servalproject/foss-comms-tower/WiFindUs-Tower/WFU_TripodEndJoiner_DN20-18.stl

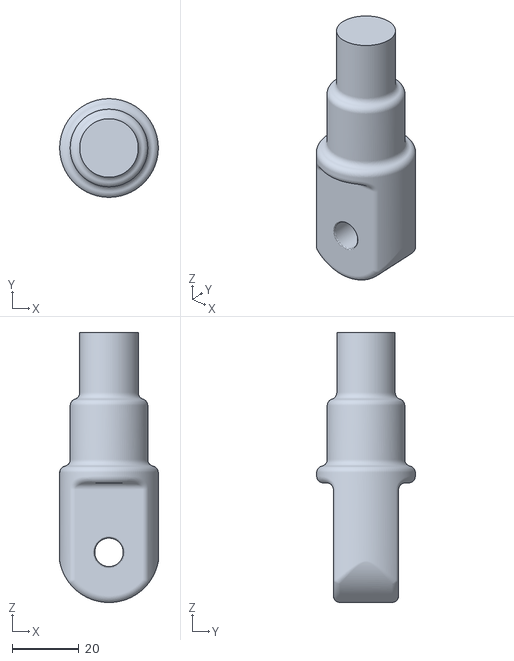
[picture p1: CAD file, 2014-07-04]
WiFindUs-Tower/WFU_TripodEndJoiner_DN20-18.stl
29.5 x 29.5 x 80.8
