servalproject/foss-comms-tower/WiFindUs-Tower/WFU_TripodLegFooting_DN25C.stl

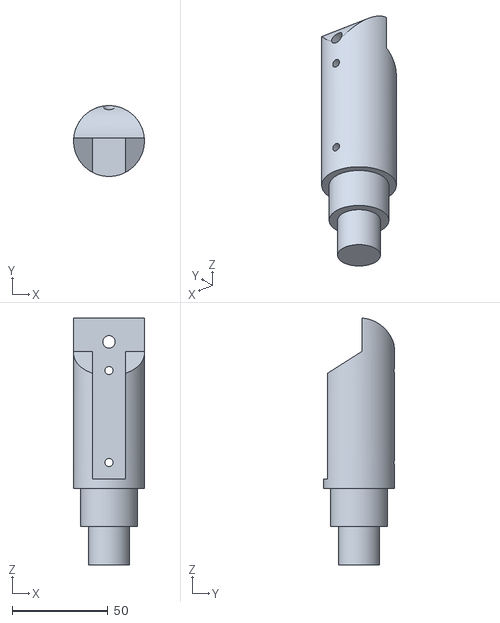
[picture p2: CAD file, 2014-07-04]
WiFindUs-Tower/WFU_TripodLegFooting_DN25C.stl
37.0 x 37.0 x 128.9
