servalproject/foss-comms-tower/WiFindUs-Tower/WFU_ElectronicsHousingInsert.stl

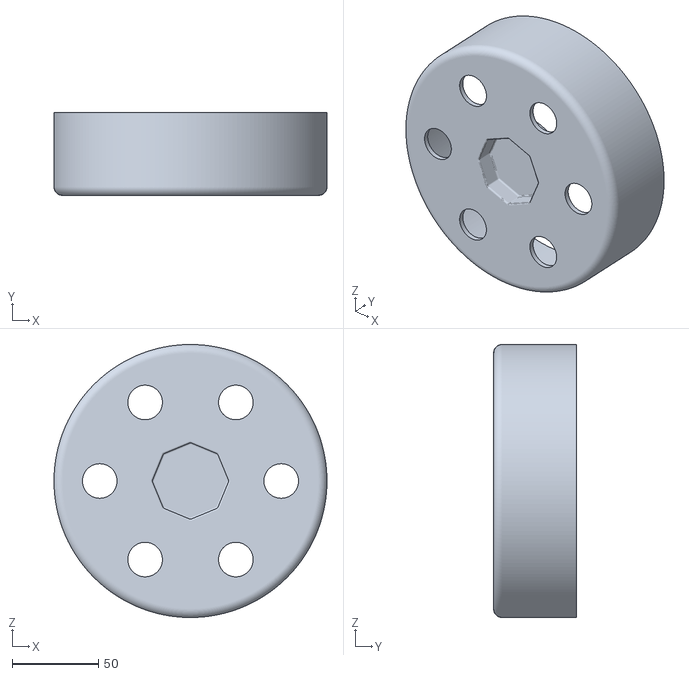
[picture p3: CAD file, 2014-07-04]
WiFindUs-Tower/WFU_ElectronicsHousingInsert.stl
158.0 x 48.0 x 158.0
