servalproject/foss-comms-tower/WiFindUs-Tower/WFU_TripodEndJoiner_DN25.stl

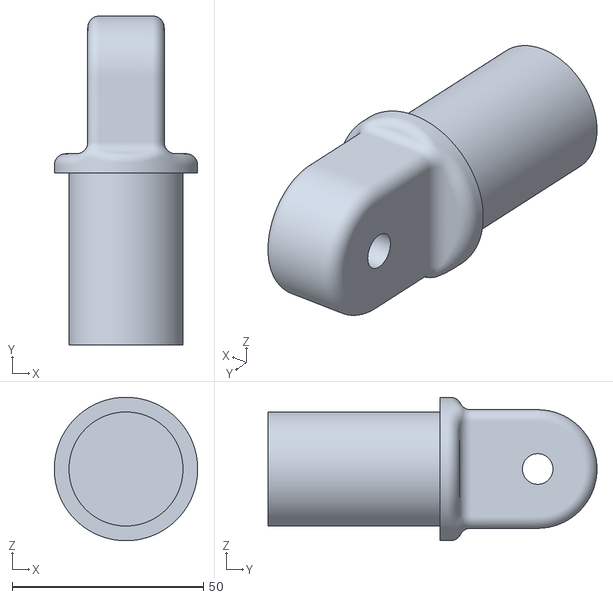
[picture p4: CAD file, 2014-07-04]
WiFindUs-Tower/WFU_TripodEndJoiner_DN25.stl
37.5 x 86.0 x 37.5
