servalproject/foss-comms-tower/WiFindUs-Tower/WFU_TripodCollar.stl

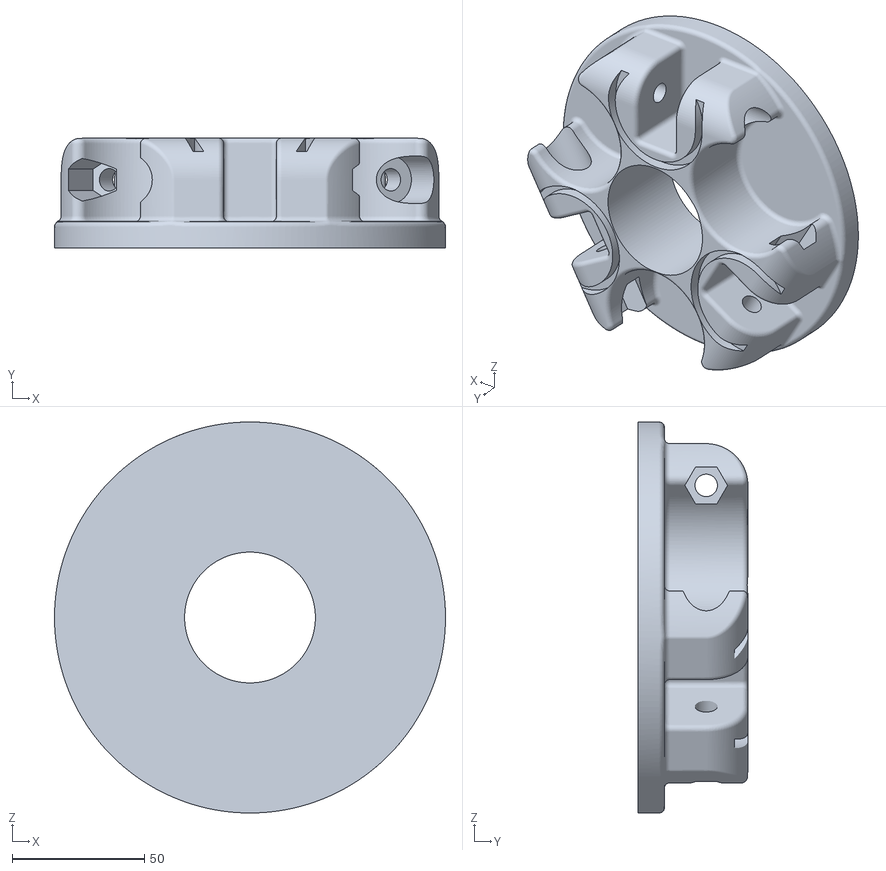
[picture p5: CAD file, 2014-07-04]
WiFindUs-Tower/WFU_TripodCollar.stl
148.0 x 41.6 x 148.0
