servalproject/foss-comms-tower/WiFindUs-Tower/WFU_TripodInlineJoiner_DN25-25C.stl

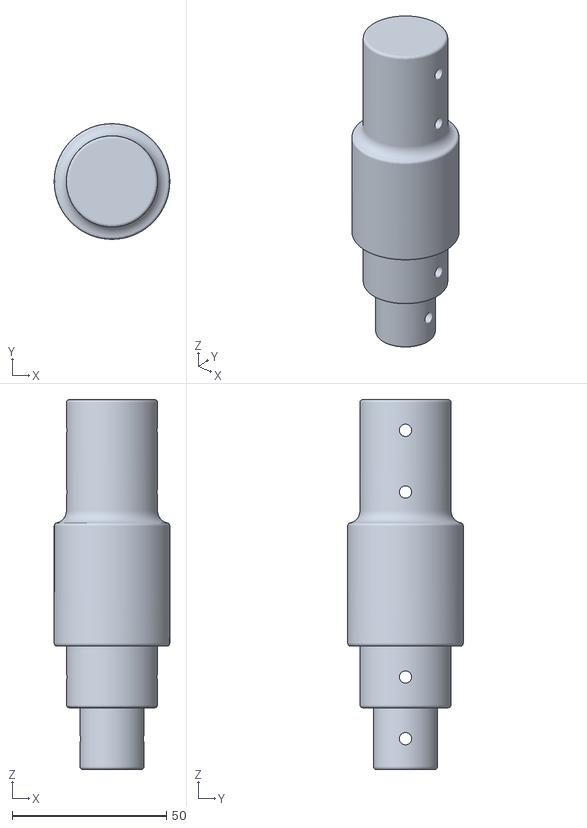
[picture p6: CAD file, 2014-07-04]
WiFindUs-Tower/WFU_TripodInlineJoiner_DN25-25C.stl
37.5 x 37.5 x 120.0
