servalproject/foss-comms-tower/WiFindUs-Tower/WFU-Tower-Assembly.pdf

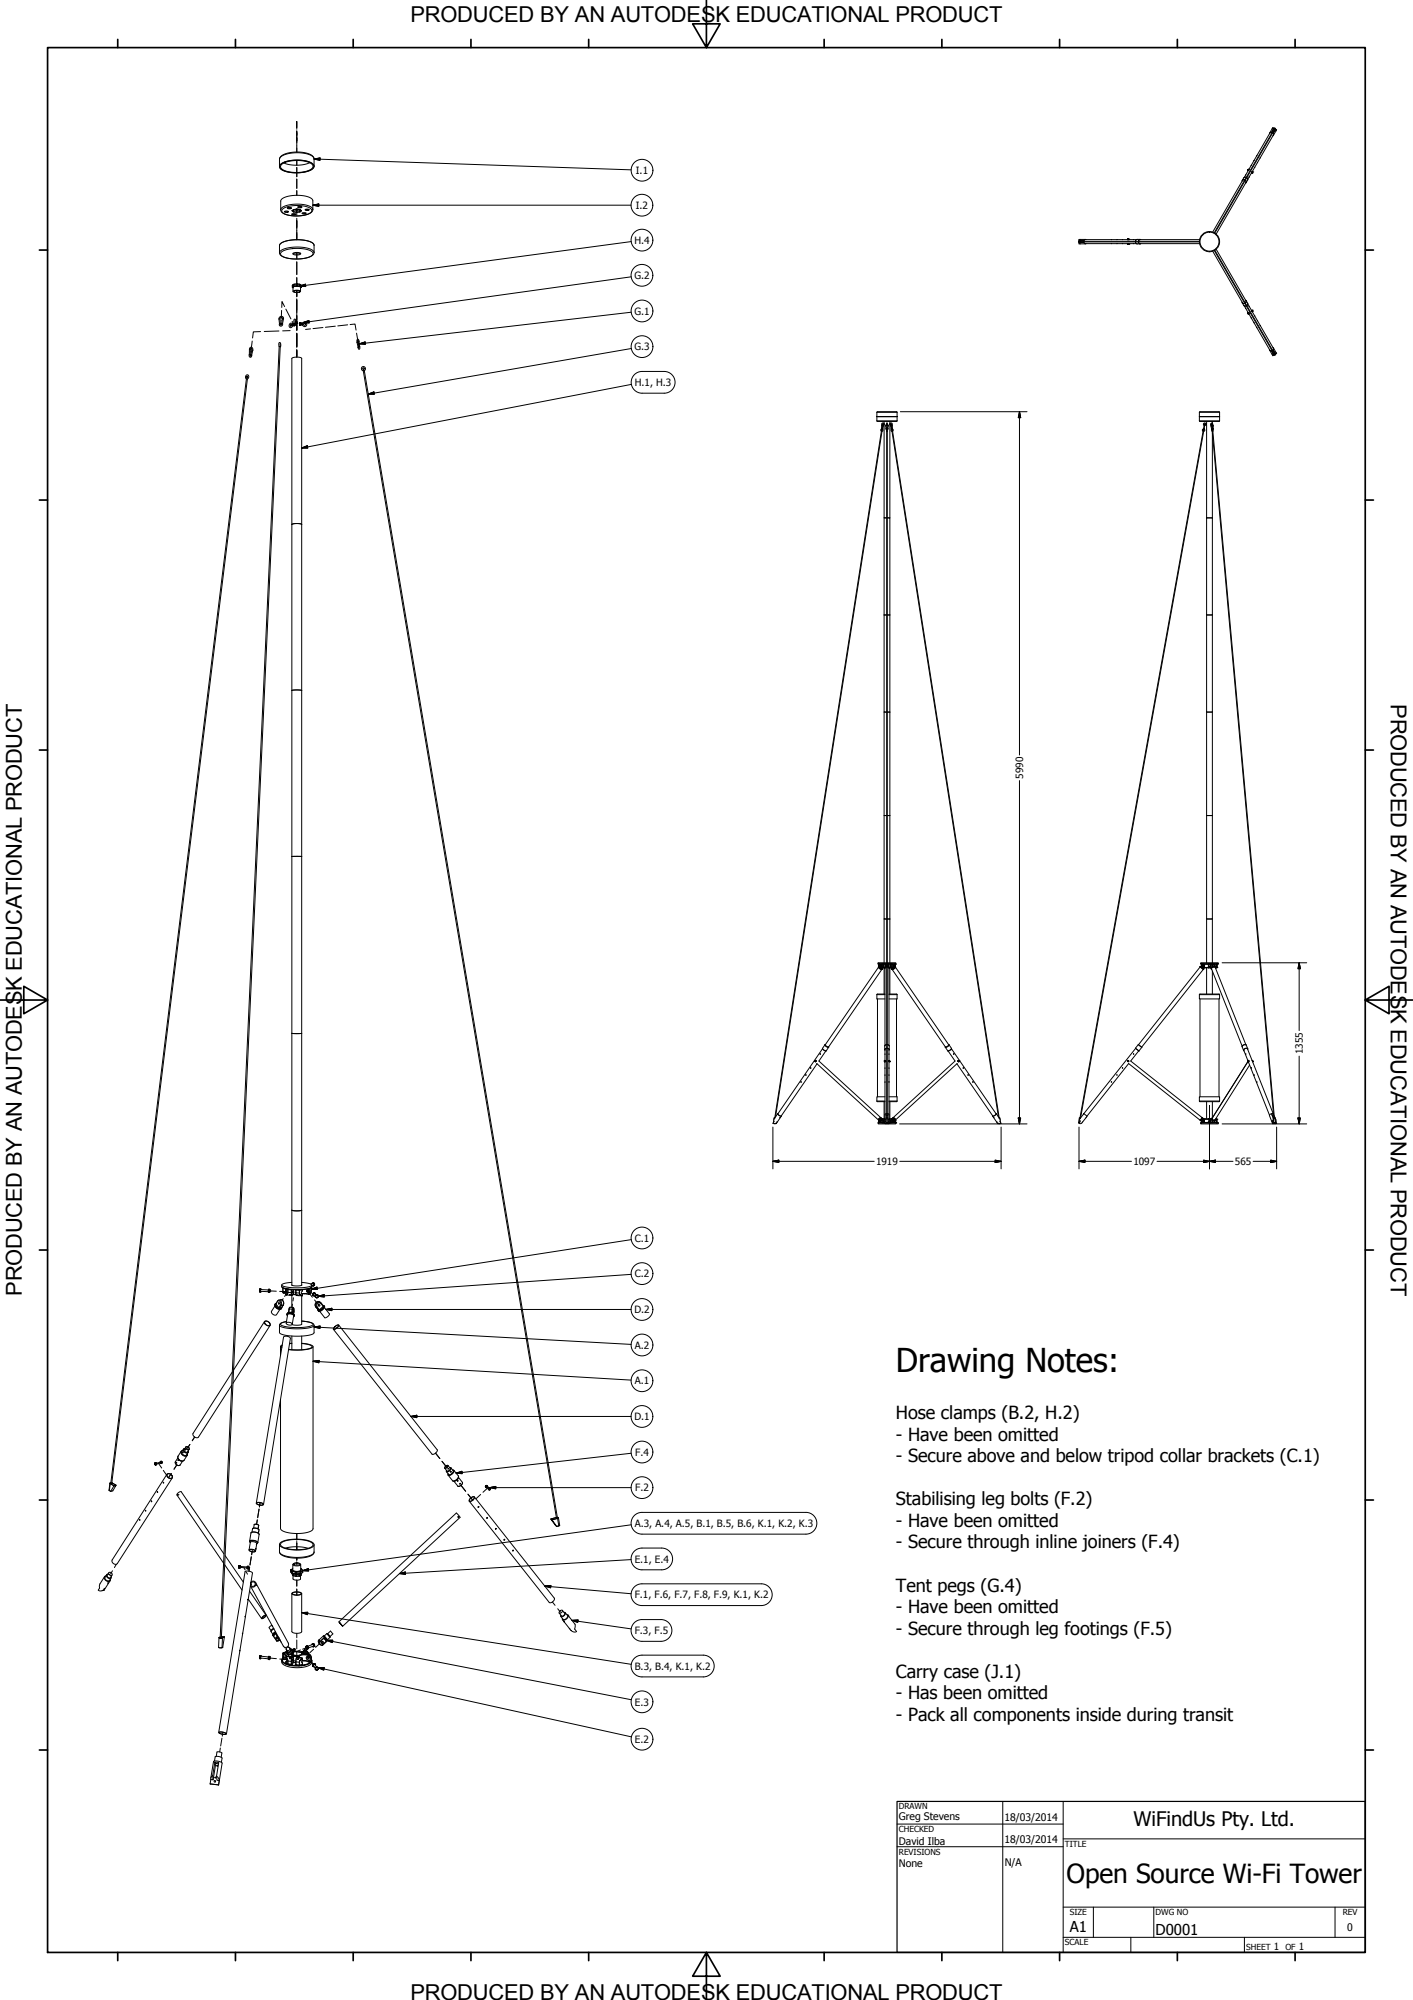
[picture p7: page 1]
TIO; P R O D U C E D B Y A N A U T O D E S K E D U C A TIO; SHEET 1 OF 1; DRAWN; CHECKED; REVISIONS; Greg Stevens; David Ilba; DWG NO D0001; TITLE; SIZE A1; SCALE; REV 0; None; Drawing Notes:

PRODUCED BY AN AUTODESK EDUCATIONAL PRODUCT

Hose clamps (B.2, H.2)
- Have been omitted
- Secure above and below tripod collar brackets (C.1)

Stabilising leg bolts (F.2)
- Secure through inline joiners (F.4)

Tent pegs (G.4)
- Secure through leg footings (F.5)

Carry case (J.1)
- Has been omitted
- Pack all components inside during transit

WiFindUs Pty. Ltd.

Open Source Wi-Fi Tower
